mitchallain/evasion-robot/CAD/rear.png

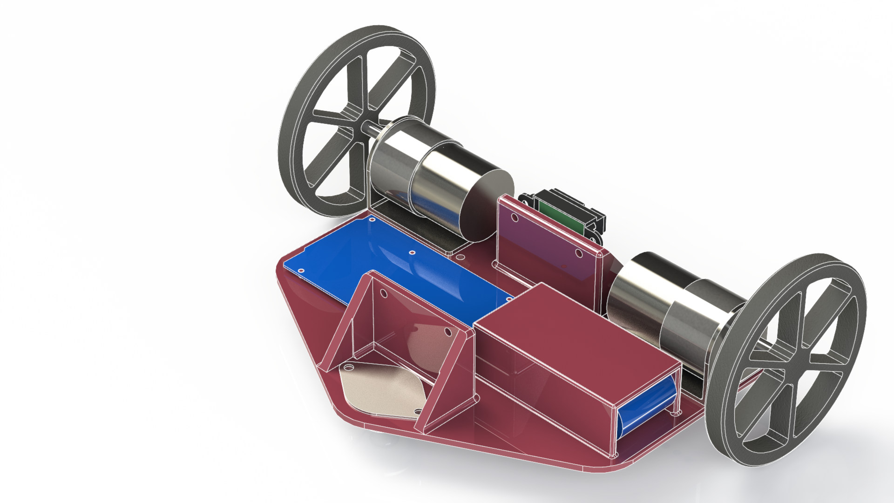
CAD/rear.png
