mitchallain/evasion-robot/CAD/plate.SLDPRT

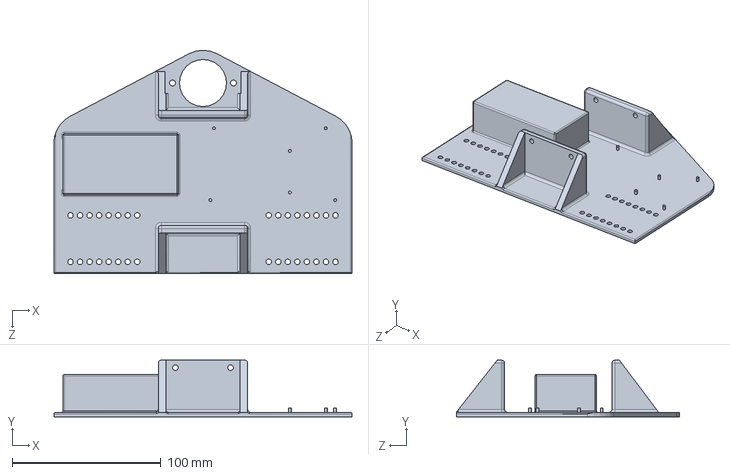
[picture p13: CAD file, 2016-12-07]
CAD/plate.SLDPRT
200.0 x 38.0 x 150.0 mm
